MacMbamba/Parero-Board/parero_DSP_board_BOM.xlsx

Comment | Description | Designator | Footprint | LibRef | Quantity | Manufacturer 1 | Manufacturer Part Number 1
100u | Multilayer Ceramic Capacitor | C1, C2, C3, C4, C48, C49 | CAP_MLCC_1206 | Cap MLCC 1206 | 6 | muRata | GRM31CR60J107KEA8L
2p7 | Multilayer Ceramic Capacitor | C5, C6, C53, C54 | CAP_MLCC_0402 | Cap MLCC 0402 | 4 | muRata | GRM1555C1H2R7CA01D
10n | Multilayer Ceramic Capacitor | C7, C43, C55 | CAP_MLCC_0402 | Cap MLCC 0402 | 3 | muRata | GRM1555C1E103GE01D
4u7 | Multilayer Ceramic Capacitor | C8, C44 | CAP_MLCC_0603 | Cap MLCC 0603 | 2 | muRata | GRM188R60J475KE19D
100n | Multilayer Ceramic Capacitor | C9, C10, C11, C12, C13, C14, C15, C16, C17, C18, C19, C20, C21, C24, C26, C29, C34, C35, C36, C37, C38, C39, C40, C50, C51, C52 | CAP_MLCC_0402 | Cap MLCC 0402 | 26 | Samsung Electro-Mechanics, [NoValue] | CL05B104KO5NNNC, [NoValue]
2u2 | Multilayer Ceramic Capacitor | C22, C23, C25, C27, C28, C30, C57, C61 | CAP_MLCC_0402 | Cap MLCC 0402 | 8 | muRata | GRM155R61A225KE95D
12p | Multilayer Ceramic Capacitor | C31, C32, C64, C65 | CAP_MLCC_0402 | Cap MLCC 0402 | 4 | muRata | GRM1555C1H120GA01D
2u2 | Multilayer Ceramic Capacitor | C33, C41 | CAP_MLCC_0603 | Cap MLCC 0603 | 2 | Samsung Electro-Mechanics | CL10A225KA8NNNC
0u1 | Multilayer Ceramic Capacitor | C42, C45, C47, C56, C58, C59, C60, C62, C63 | CAP_MLCC_0402 | Cap MLCC 0402 | 9 | Samsung Electro-Mechanics | CL05B104KO5NNNC
2n2 | Multilayer Ceramic Capacitor | C46 | CAP_MLCC_0402 | Cap MLCC 0402 | 1 | muRata | GRM1555C1H222GA01D
0.01u | Multilayer Ceramic Capacitor | C66, C67 | CAP_MLCC_0402 | Cap MLCC 0402 | 2 | muRata | GRM1555C1E103GE01D
1000p | Multilayer Ceramic Capacitor | C68 | CAP_MLCC_0402 | Cap MLCC 0402 | 1 | muRata | GRM1555C1H102JA01D
P0603P1R09G12 | 20mA 350mcd 621nm Red 2V 0603 LED Indication - Discrete ROHS | D1, D2 | LED_0603 | Diode LED R | 2 | Silverlight | P0603P1R09G12
P0603P1N46G12 | 1200mcd 518nm~524nm Green 3V 0603 LED Indication - Discrete ROHS | D3 | LED_0603 | Diode LED G | 1 | Silverlight | P0603P1N46G12
BLM21PG331SN1D | 70mΩ ±25% 330Ω@100MHz 0805 Ferrite Beads and Chips RoHS | FB1, FB2 | FBEAD_0805 | Filter Ferrite Bead 0805 | 2 | muRata | BLM21PG331SN1D
GT-USB-7010ASV | USB 2.0 1 16P -40℃~+85℃ Type-C SMD USB, DVI, HDMI Connector Assemblies ROHS | J1 | CONN_CH_USB_SMD_USB | Connector USB-C CH | 1 | G-Switch | GT-USB-7010ASV
ZX-PZ2.54-2-25PZZ | 2x25P 50P Gold Brass -40℃~+105℃ Pin Header Black 2.54mm 2.5mm 6mm 1kV 3mm 3A 2 Through Hole 2.54mm Through Hole,P=2.54mm Headers, Male Pins RoHS | J2 | PIN_HEADER_2X25P | Pin Header 2X25 Pitch 2.54mm | 1 | Megastar | ZX-PZ2.54-2-25PZZ
FH34SRJ-6S-0.5SH(50) | -55℃~+105℃ 6P 0.5mm Double-Sided Contacts, Top and Bottom Entry Surface Mount, Right Angle SMD,P=0.5mm,Surface Mount,Right Angle FFC, FPC (Flat Flexible) Connector Assemblies RoHS | J3 | CONN_CH_SMD_FPC_40P | Connector FFC_40PH CH | 1 | HRS | FH34SRJ-6S-0.5SH(50)
FH34SRJ-6S-0.5SH(50) | -55℃~+105℃ 6P 0.5mm Double-Sided Contacts, Top and Bottom Entry Surface Mount, Right Angle SMD,P=0.5mm,Surface Mount,Right Angle FFC, FPC (Flat Flexible) Connector Assemblies RoHS | J4 | CONN_CH_SMD_FPS_6P | Connector FFC_6PH CH | 1 | HRS | FH34SRJ-6S-0.5SH(50)
TF-01A | Push-Push 1.85mm Connector and Ejector MicroSD Card (TF Card) SMD PC Card Sockets ROHS | J5 | CONN_CH_SMD_SD_CARD | Connector SD Card CH | 1 | Korean Hroparts Elec | TF-01A
HY931147C | 1 With LED Through Hole Modular/Ethernet Connector Jacks With Magnetics RoHS | J6 | CONN_ETH_RJ45 | Connector RJ45 MagJack | 1 | HANRUN(Zhongshan HanRun Elec) | HY931147C
10R | General Purpose SMD Carbon Resistor | R1, R22 | RES_SMD_0402 | Resistor 0402 | 2 | UNI-ROYAL | 0402WGF100JTCE
100R | General Purpose SMD Carbon Resistor | R2, R3, R10 | RES_SMD_0402 | Resistor 0402 | 3 | UNI-ROYAL | 0402WGF1000TCE
5k1 | General Purpose SMD Carbon Resistor | R4, R5 | RES_SMD_0402 | Resistor 0402 | 2 | UNI-ROYAL | 0402WGF5101TCE
4k7 | General Purpose SMD Carbon Resistor | R6, R7, R11, R12, R13, R14, R15, R21, R24, R25 | RES_SMD_0402 | Resistor 0402 | 10 | UNI-ROYAL | 0402WGF4701TCE
10k | General Purpose SMD Carbon Resistor | R8 | RES_SMD_0402 | Resistor 0402 | 1 | UNI-ROYAL | 0402WGF1002TCE
29R4 | General Purpose SMD Carbon Resistor | R9 | RES_SMD_0603 | Resistor 0603 | 1 | UNI-ROYAL | 0603WAF294JT5E
47k | General Purpose SMD Carbon Resistor | R16, R17, R18, R19, R20 | RES_SMD_0402 | Resistor 0402 | 5 | UNI-ROYAL | 0402WGF4702TCE
2k49 | General Purpose SMD Carbon Resistor | R23 | RES_SMD_0402 | Resistor 0402 | 1 | UNI-ROYAL | 0402WGF2491TCE
510R | General Purpose SMD Carbon Resistor | R26, R27 | RES_SMD_0402 | Resistor 0402 | 2 | UNI-ROYAL | 0402WGF5100TCE
75R | General Purpose SMD Carbon Resistor | R28, R29 | RES_SMD_0402 | Resistor 0402 | 2 | UNI-ROYAL | 0402WGF750JTCE
TS-1088-AR02016 | Without Bracket 4mm 12V 3mm Round Button SPST 50mA SMD,4x3mm Tactile Switches ROHS | SW1, SW2 | SW_SMD_SPST | Switch SMD SPST | 2 | XUNPU | TS-1088-AR02016
AMS1117-3.3 | Positive Fixed 3.3V SOT-223 Voltage Regulators - Linear, Low Drop Out (LDO) Regulators ROHS | U1, U2 | AMS117-3.3_SOT223 | Regulator LDO AMS1117-3.3 | 2 | TECH PUBLIC | AMS1117-3.3
STM32H750IBT6 | ARM Cortex-M Series 480MHz 140 LQFP-176(24x24) Microcontrollers RoHS | U3 | STM32H750IBT6_176QFP | MCU STM32H750IBT6 | 1 | ST | ARM Cortex-M Series 480MHz 140 LQFP-176(24x24) Microcontrollers RoHS
TJA1050 | 1Mbps 4.75V~5.25V 50mA CAN Transceiver SOP-8 CAN Transceivers ROHS | U4 | TJA1050 | Interface CAN Transceiver TJA1050 | 1 | NXP Semicon | TJA1050T/CM,118
W9864G6KH-6I | 64Mbit 3V~3.6V 166MHz TSOP-54-10.2mm Memory (ICs) RoHS | U5 | W9864G6KH-6I-TSOP54 | Memory SDRAM W9864G6KH-6I | 1 | Winbond | W9864G6KH-6I
MPU-6050 | Accelerometer Gyroscope I2C QFN-24-EP(4x4) Accelerometers ROHS | U6 | MPU-6050 | Sensor MPU-6050 | 1 | TDK InvenSense | MPU-6050
SR8201F | Single-chip 10/100M Ethernet PHYceiver, supporting Auto MDIX | U7 | SR8201F_QFN32 | Interface ETHERNET PHY SR8201F | 1 | CoreChips | SR8201F
XC32M4-8.000-F12LJDT | Crystal Oscillator 12pF SMD3225-4P Crystals RoHS | X1 | XTAL_SMD_HCL | Crystal SMD 8MHz | 1 | HCI | XC32M4-8.000-F12LJDT
X322525MOB4SI | Crystal Oscillator 12pF SMD3225-4P Crystals ROHS | X2 | XTAL_SMD_YXC | Crystal SMD 25MHz | 1 | YXC Crystal Oscillators | X322525MOB4SI
