MacMbamba/Parero-Board/schematic_sheet.pdf

1

2

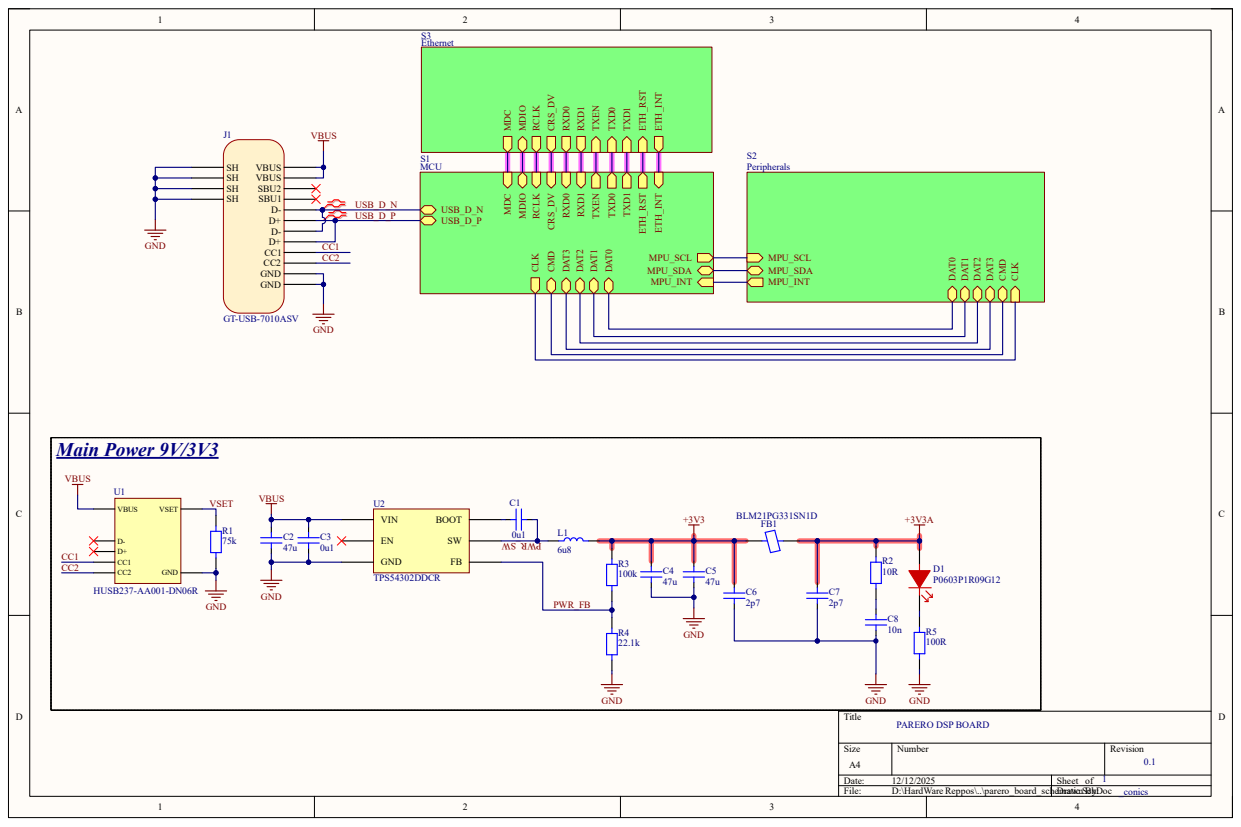
[picture p1: page 1]

Peripherals MDC MDIO RCLK CRS_DV RXD⁰ RXD¹ TXEN TXD⁰ TXD¹ ETH_RST ETH_INT

MPU_SCL CLK CMD DAT³ DAT² DAT¹ DAT⁰

# PI11 VSS VDD

# PF5 VSS VDD

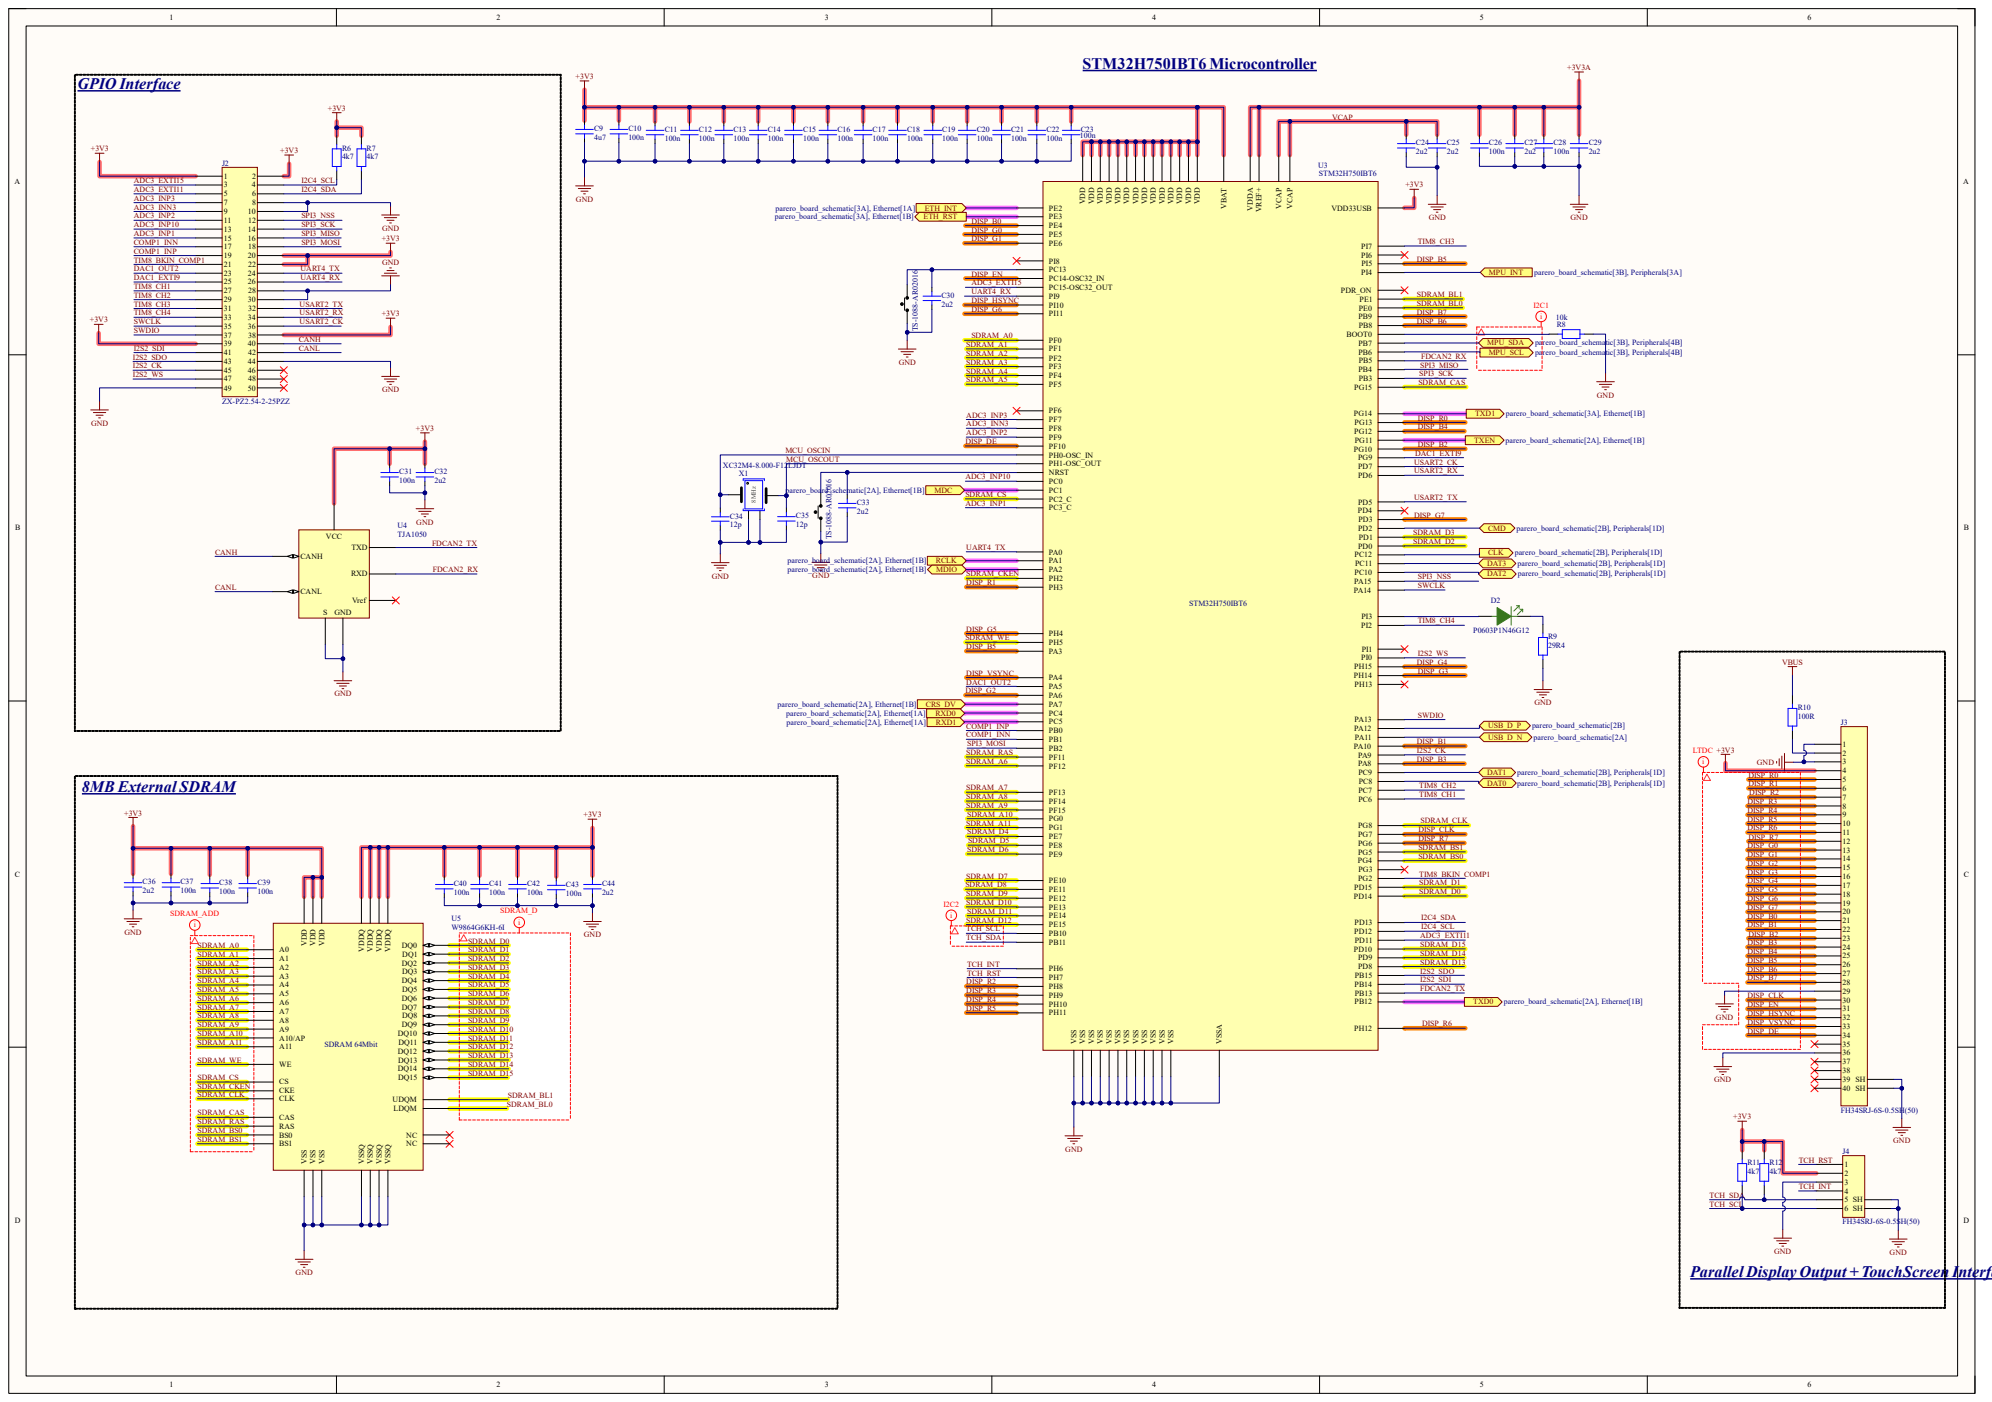
[picture p2: page 2]

C40 100n | C41 100n | C42 100n | C43 100n | SDRAM_D6

Parallel Display Output + TouchScreen Interface

1

2

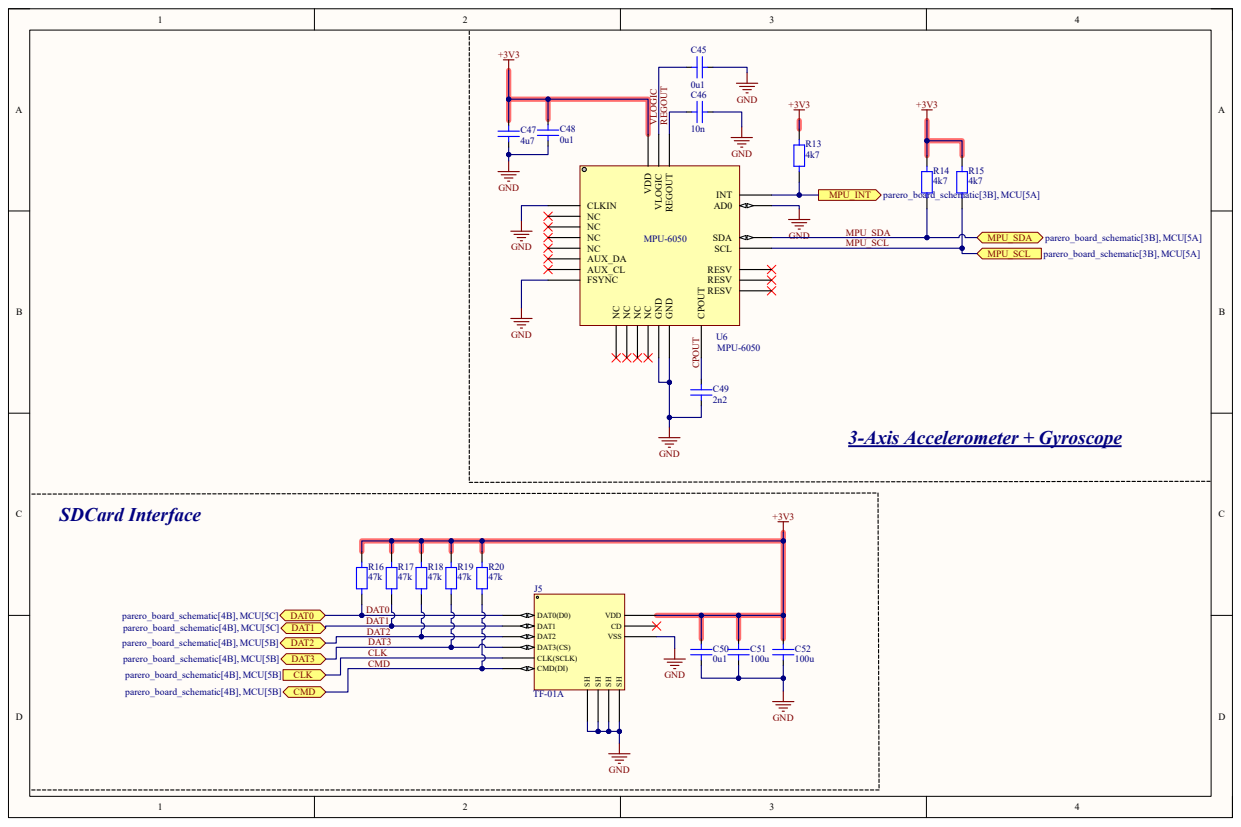
[picture p3: page 3]

1

2

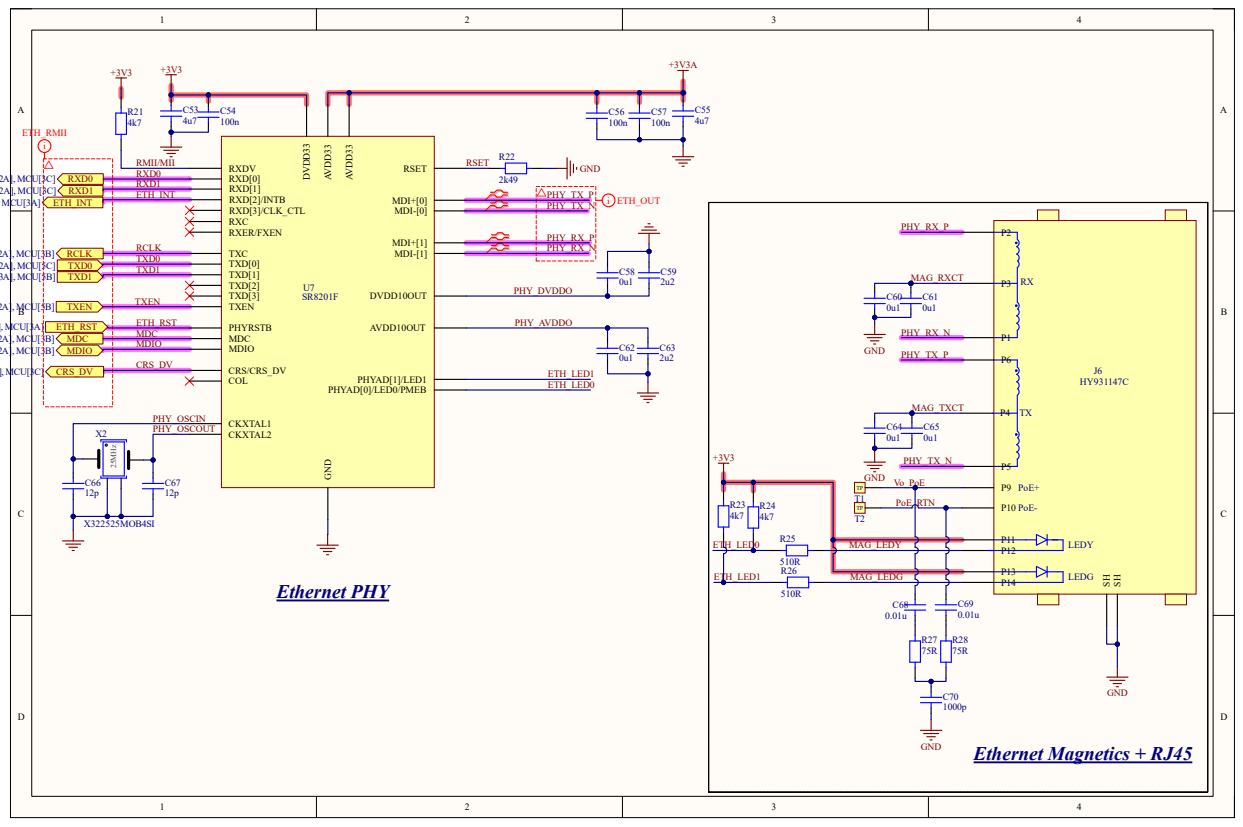
[picture p4: page 4]
