MacMbamba/Parero-Board/pcb_sheet.pdf

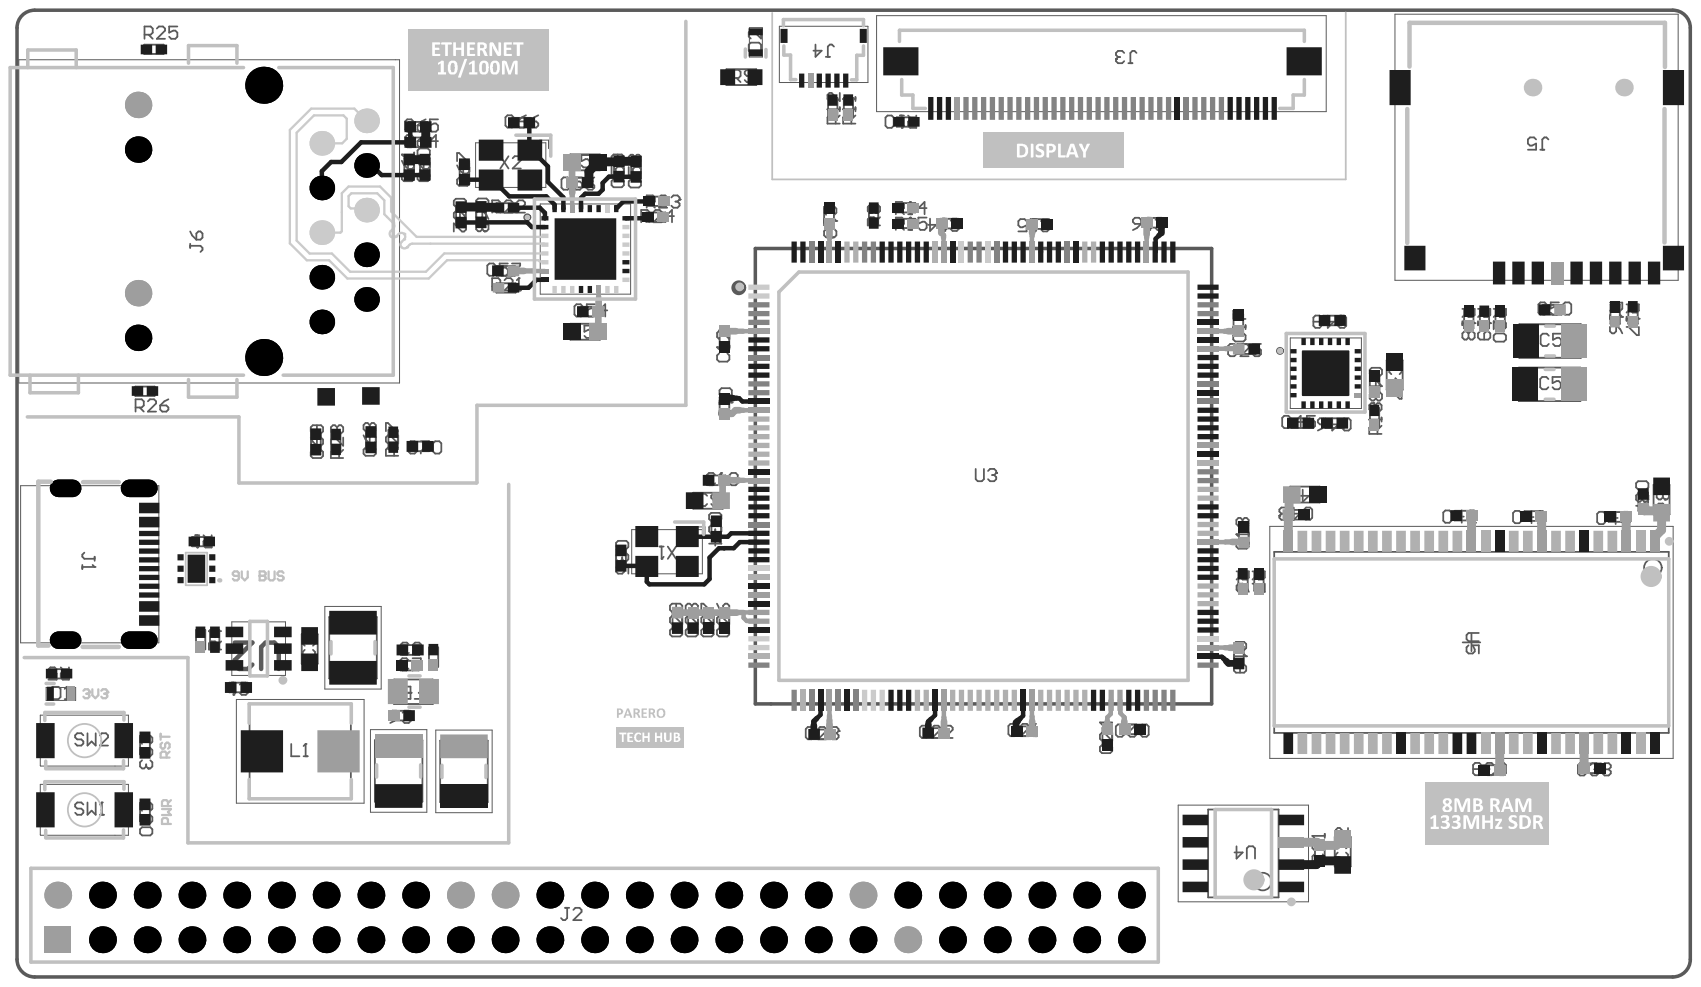
[picture p5: page 1]
