MacMbamba/Parero-Board/(list of files, drawings)

Other design files:
Ethernet.SchDoc
MCU.SchDoc
parero_board_schematic.SchDoc
parero_DSP_board.PrjPcb
Peripherals.SchDoc
