MacMbamba/Parero-Board/(commit log)

2025-11-12 Added FFC interface for Display and Touch controller
    [MCU.SchDoc]
2025-11-12 FFC & I2C interface added in the schematic
2025-11-20 Synchronized pin connections to the sheets
    [MCU.SchDoc]
2025-11-20 Interfaced SD Connector and Accelerometer to the MCU
    [Peripherals.SchDoc]
2025-11-20 Added External 8MB RAM, Display and Touch screen controller interfaces
    [parero_DSP_board.PrjPcb, parero_board_schematic.SchDoc]
2025-11-20 Pictorial representation of a circuit
2025-12-01 Added 10/100M Ethernet interface + PHY
    [Ethernet.SchDoc]
2025-12-01 Splitted the power Domains, MCU power and Peripheral power with separate Regulators
    [parero_board_schematic.SchDoc]
2025-12-01 New Exported schematic pdf
2025-12-01 Added 2 100uF bulk caps near SD Card Interface to prevent turning off resulting from transient when card is inserted
    [Peripherals.SchDoc]
2025-12-01 Added FDCAN Interface to enable for wider sensor network communication
    [MCU.SchDoc]
2025-12-01 Added 10/100Mbps ethernet interface, FDCAN, Pin Header for GPIO/Serial Communication Interfacing
    [parero_DSP_board.PrjPcb]
2025-12-02 Prepared a Bill of Matereal
    [Ethernet.SchDoc, MCU.SchDoc, Peripherals.SchDoc, parero_DSP_board.PrjPcb, parero_board_schematic.SchDoc]
2025-12-02 Updated Schematic View, PDF
2025-12-12 Created PCB sheet & Designed components layout
    [parero_DSP_board.PrjPcb]
2025-12-12 Changed Power Supply Scheme to 9V from USB PD enabled PDN and additional 9V-3V3 Buck regulator
    [parero_board_schematic.SchDoc]
2025-12-12 Bug Fixes and BOM Update
    [Ethernet.SchDoc, MCU.SchDoc, Peripherals.SchDoc]
2025-12-12 2D PCB viewer
2025-12-12 Updated BOM in xls format
    [parero_DSP_board_BOM.xlsx]
